ELtime1285/optical-density-meter-of-a-substance/Наглядная схема.jpg

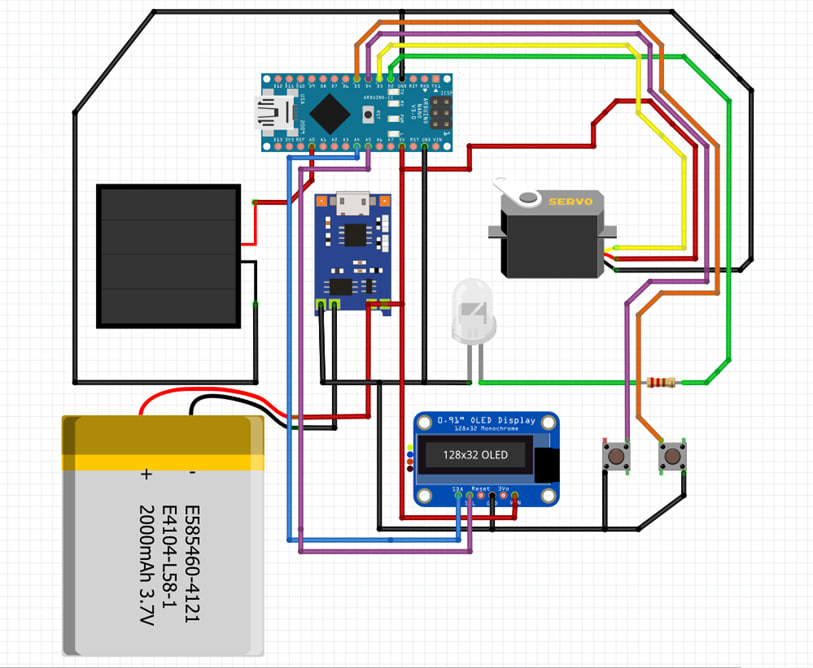
Наглядная схема.jpg
