ELtime1285/optical-density-meter-of-a-substance/фото установки/IMG_7575.jpeg

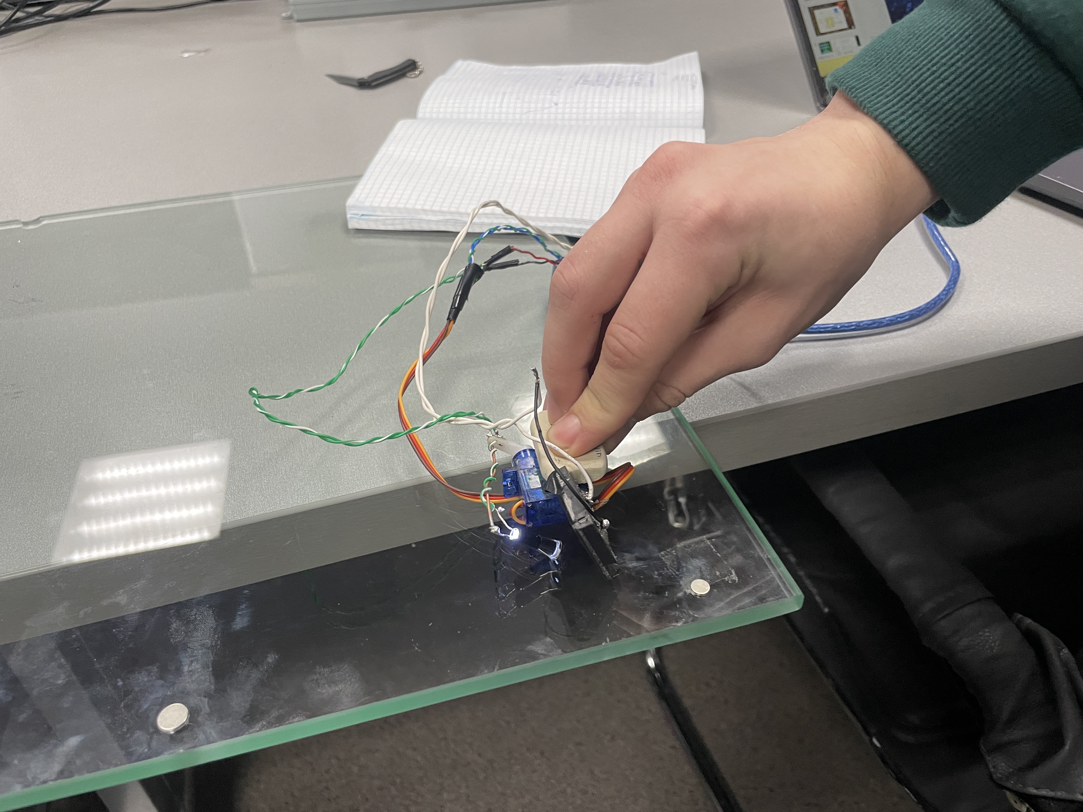
фото установки/IMG_7575.jpeg
