ELtime1285/optical-density-meter-of-a-substance/Алгоритм устройства.pdf

Алгоритм программы | Алгоритм измерения опт. плотности

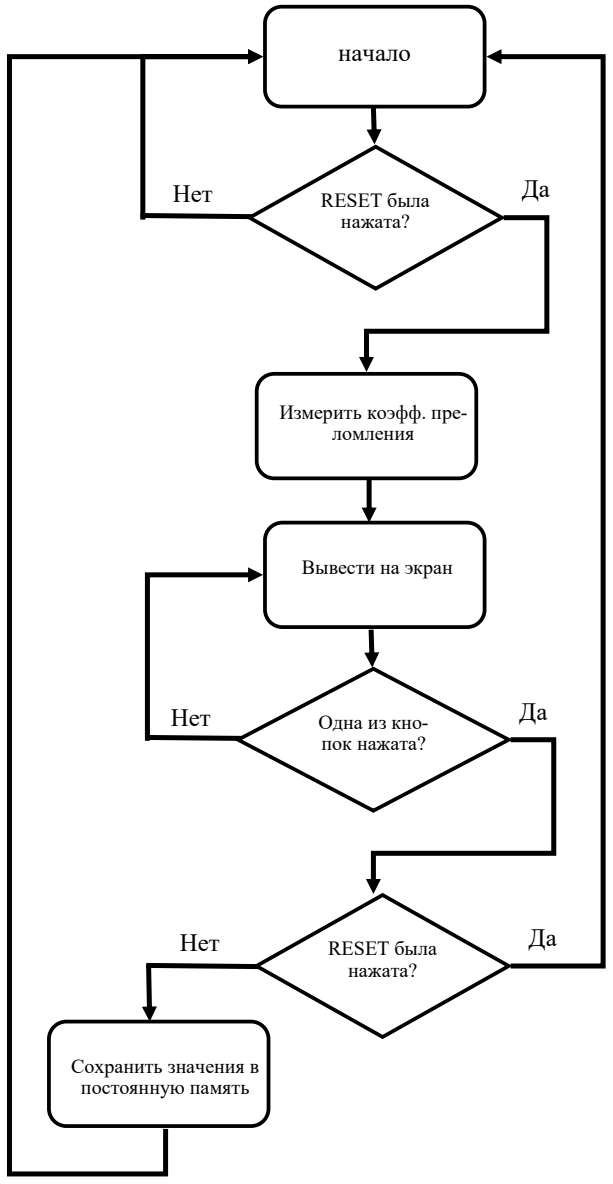
[picture p3: figure]
начало; Измерить коэфф. пре- ломления; RESET была нажата?; Нет; Вывести на экран; Одна из кно- пок нажата?; Сохранить значения в постоянную память
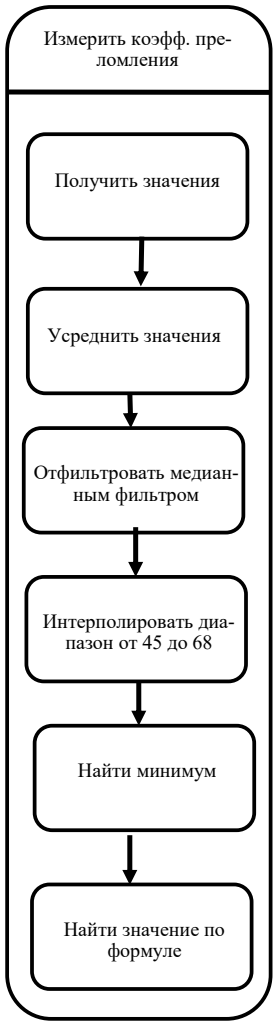
[picture p4: figure]
Усреднить значения; Отфильтровать медиан- ным фильтром; Интерполировать диа- пазон от 45 до 68; Найти минимум; Найти значение по формуле; Получить значения; Измерить коэфф. пре- ломления
