ELtime1285/optical-density-meter-of-a-substance/Принципиальная схема.jpg

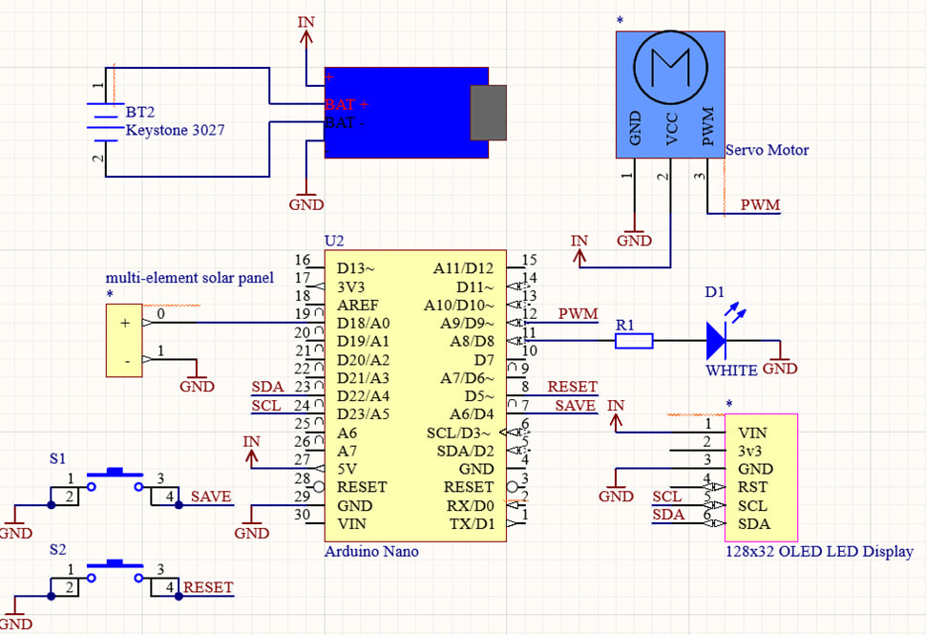
Принципиальная схема.jpg
