ELtime1285/optical-density-meter-of-a-substance/Схема установкиpng.png

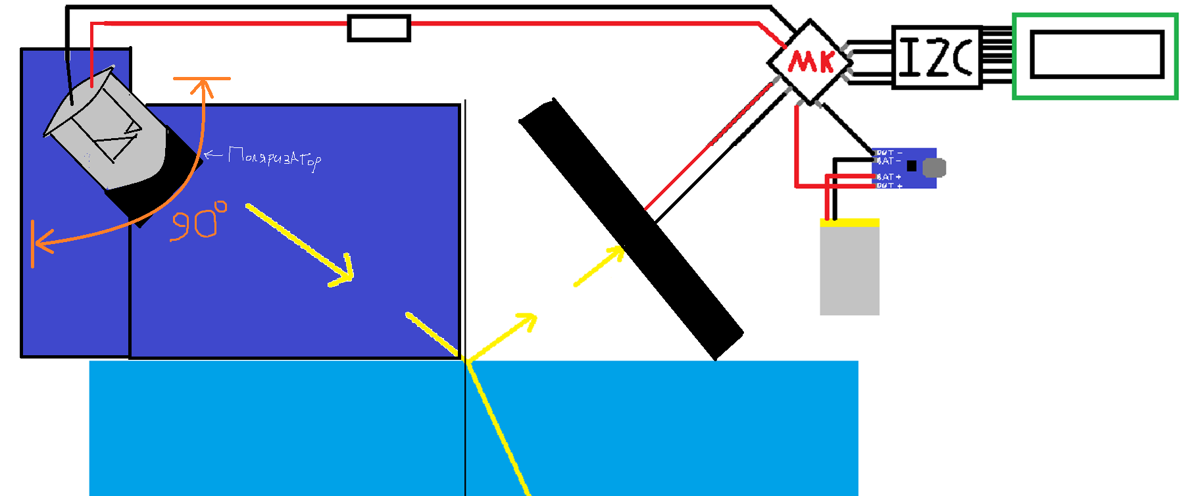
Схема установкиpng.png
