ELtime1285/optical-density-meter-of-a-substance/фото установки/IMG_7576.jpeg

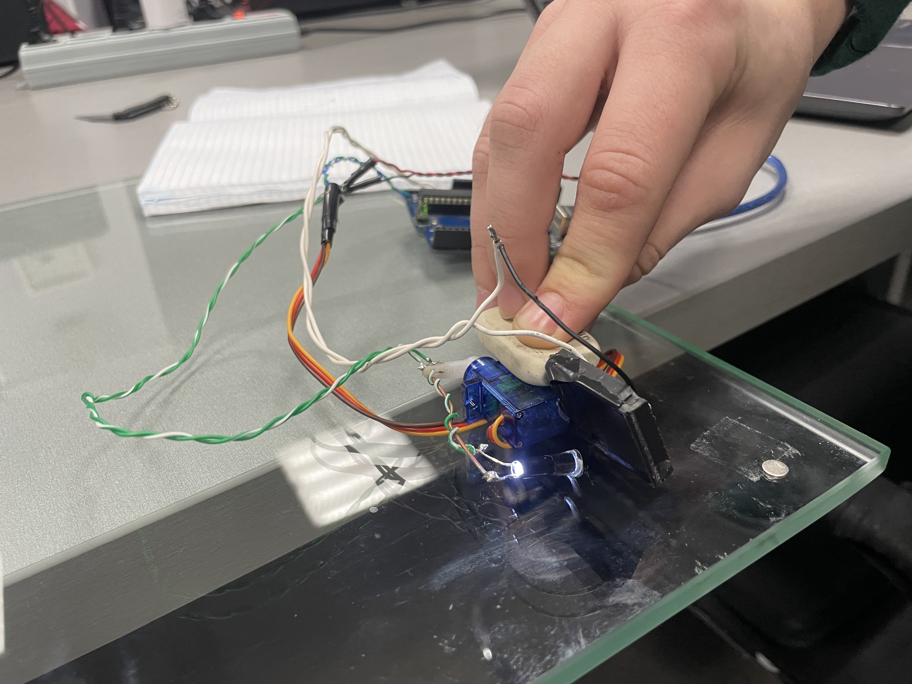
фото установки/IMG_7576.jpeg
