ELtime1285/optical-density-meter-of-a-substance/список компонентов.xlsx

Компонент | Цена | Откуда взят
Ардуино Нано | 264 ₽ | https://www.ozon.ru/product/kontroller-arduino-nano-type-c-v3-0-sovmestimyy-atmega328-ch340-neraspayannaya-1193400460/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
Сервопривод SG90 | 245 ₽ | https://www.ozon.ru/product/servoprivod-sg-90-180-gradusov-9g-arduino-249254883/?avtc=1&avte=2&avts=1702297560
Севетодиод | 3 ₽ | https://shop.robotclass.ru/index.php?product_id=1362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
Поляризатор | 206 ₽ | Пленка на экране сматрфона; https://www.ozon.ru/product/plenka-polyarizatsionnaya-universalnaya-152-201-mm-326345929/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
Солнечная пластина | 145 ₽ | https://www.ozon.ru/product/sadovyy-svetilnik-na-solnechnoy-bataree-trapetsiya-4-5-h-30-h-4-5-sm-1-led-svechenie-beloe-996801067/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
Лазер | 120 ₽ | https://www.ozon.ru/product/lazernyy-mednyy-diod-6mm-rck353000-5v-942788162/?avtc=1&avte=2&avts=1702368271
Себестоимость продукта со светодиодом | 863 ₽
Себестоимость продукта с лазером | 980 ₽
