ELtime1285/optical-density-meter-of-a-substance/(list of files, cad)

Other CAD files:
korpus.blend
