ELtime1285/optical-density-meter-of-a-substance/(list of files, drawings)

Other design files:
плата для рефрактометра.lay6
